Erk-men/stm32-ppg-heart-rate-monitor/Src/systick.c

#include "stm32f0xx.h"
#include "systick.h"

/* D-03: counter is file-local, not exposed via extern */
static volatile uint32_t s_ticks = 0;

void systick_init(void)
{
    /* LOAD = 7999 → (8,000,000 Hz / 1000 Hz) - 1 = 1 ms at HCLK=8MHz */
    SysTick_Config(7999);

    /* Raise SysTick to highest priority per CLAUDE.md §Interrupt Priority Plan */
    NVIC_SetPriority(SysTick_IRQn, 0);
}

uint32_t millis(void)
{
    /* Single 32-bit aligned LDR is atomic on Cortex-M0 — no need to disable interrupts */
    return s_ticks;
}

/* D-02: ISR lives in the driver file that owns the counter */
void SysTick_Handler(void)
{
    s_ticks++;
}
