Erk-men/stm32-ppg-heart-rate-monitor/(commit log)

2026-05-12 feat(01-01): implement SysTick millis() driver (DRV-01)
    - Inc/systick.h: declare systick_init() and millis() public API
    - Src/systick.c: static volatile s_ticks counter (D-03, not extern)
    - SysTick_Config(71999) for 1ms tick at HCLK=72MHz
    - NVIC_SetPriority(SysTick_IRQn, 0) per interrupt priority plan
    - SysTick_Handler lives in systick.c per D-02 (not stm32f1xx_it.c)
2026-05-12 feat(01-01): wire main.c to systick_init() and millis() loop
    - Include systick.h, call systick_init() after SystemInit()
    - 1Hz loop body uses unsigned subtraction (now - last) for rollover safety
    - __NOP() breakpoint anchor; Plan 02 will replace with uart_write call
    - No HAL_ calls
    [main.c]
2026-05-12 feat(phase-01): project scaffold, CMSIS headers, SysTick driver, main stub
    - STM32CubeIDE Empty project for Nucleo-F103RB (Cortex-M3, 72MHz HSE+PLL)
    - Downloaded CMSIS Core + STM32F1xx device headers into Drivers/
    - system_stm32f1xx.c: SystemInit with HSE 8MHz x PLL9 = 72MHz clock tree
    - stm32f1xx_it.c: default handler stubs; SysTick_Handler absent (lives in systick.c)
    - Inc/systick.h + Src/systick.c: DRV-01 — SysTick_Config(71999), NVIC pri 0, millis()
    - Src/main.c: calls systick_init(), 1Hz breakpoint loop on millis()
    - Builds clean: 0 errors, 0 warnings; flashes to board successfully
    Pending: Task 4 hardware verify (millis() debugger check) — resume next session.
2026-05-19 docs(01-01): close out plan with SUMMARY.md — tasks 1-3 complete, hw verify deferred to 01-02
2026-05-19 feat(01-02): implement USART2 polling TX driver (DRV-02)
    - Inc/usart.h: declares usart2_init(), uart_write_str(), uart_write_u32()
    - Src/usart.c: GPIOA clock on APB2, USART2 clock on APB1, BRR=0x139 (115200@36MHz)
    - PA2 CRL nibble=0xB (AF push-pull 50MHz), PA3 CRL nibble=0x4 (floating input)
    - TXE-poll TX loop; uart_write_u32 handles 0 and UINT32_MAX via 10-char stack buf
    - No stdlib formatting, no HAL, no DMA, no interrupts
2026-05-19 feat(01-02): wire main.c to print millis via USART2 every 1000ms
    - Add #include "usart.h"; call usart2_init() after systick_init()
    - Print banner "\r\n--- HeartRateSensor Phase 1 ---\r\n" on reset
    - 1Hz branch: uart_write_str("millis: ") + uart_write_u32(now) + uart_write_str("\r\n")
    - Unsigned subtraction (now - last) rollover-safe per threat model
    - No HAL, no delay loops
    [main.c]
2026-05-19 fix(01-02): add stddef.h for NULL in usart.c
    [usart.c]
2026-05-19 feat(port): migrate project from STM32F103RB to STM32F070RB
    - Add F070xB CMSIS headers (stm32f0xx.h, stm32f070xb.h, core_cm0.h)
    - Rewrite system_stm32f0xx.c: HSE 8MHz x PLL6 = 48MHz clock tree
    - Rewrite usart.c: MODER/AFR GPIO config, ISR/TDR registers, BRR=0x1A1
    - Update systick.c: SysTick_Config(47999) for 1ms at 48MHz HCLK
    - Update all includes: stm32f1xx.h -> stm32f0xx.h
    - Update build: cortex-m0, STM32F070xB defines, F070 startup file
    - Add F070 linker script (same 128KB/16KB memory layout as F103)
2026-05-19 debug(f070): switch to HSI 8MHz diagnostic build (BRR=0x45, SysTick=7999)
    No serial output yet. Suspected causes: wrong USART2 AF number or
    GPIO not reaching PA2. Next: verify AF table from F070 datasheet.
    [usart.c]
2026-05-19 docs(02): research phase ADC+TIM3 hardware trigger for STM32F070xB
2026-05-19 docs(02): create Phase 2 ADC + TIM3 hardware trigger plans
    Two-plan wave structure for Phase 2 (STM32F070RB):
    - 02-01-PLAN: tim3.c/h (PSC=79,ARR=999,TRGO) + adc.c/h (HSI14, ADCAL, TIM3_TRGO EXTSEL=011, ADC1_IRQHandler)
    - 02-02-PLAN: wire drivers into main.c, stream "adc: NNNN\r\n", human-verify range + 100Hz rate
    All register values sourced from 02-RESEARCH.md (F070-specific). No TIM2, no F103 register names.
2026-05-19 feat(02-01): add TIM3 100 Hz TRGO driver
    - PSC=79, ARR=999 -> 100 Hz update event at HSI 8 MHz
    - CR2=TIM_CR2_MMS_1 routes Update Event to TRGO output for ADC1 trigger
    - No TIM3 interrupt enabled; counter runs autonomously
    - No EGR.UG to avoid spurious startup TRGO pulse
    [tim3.c]
2026-05-19 feat(02-01): add ADC1 hardware-triggered ISR driver
    - PA0 analog mode, HSI14 14MHz ADC clock, single-step ADCAL calibration
    - CFGR1: EXTSEL=011 (TIM3_TRGO), EXTEN=01 (rising edge), OVRMOD set
    - SMPR=0x7 (239.5 cycle sample time for max SNR at 100Hz)
    - CHSELR=CHSEL0 (ADC_IN0 = PA0), IER=EOCIE, NVIC priority 1
    - ADC1_IRQHandler stores 12-bit DR into g_adc_sample, sets g_adc_ready=1
    - No F103 register names (RSTCAL/SQR3/SMPR2/CR2/ADC1_2_IRQn)
2026-05-19 docs(02-01): complete ADC + TIM3 hardware trigger drivers plan
    - SUMMARY.md for plan 02-01: tim3.c/h and adc.c/h drivers
    - Records decisions: TIM3 not TIM2, PSC=79, HSI14 clock, EXTSEL=011
    - Self-check: PASSED
2026-05-19 feat(02-02): wire tim3_init + adc_init into main.c with 100 Hz ADC print loop
    - Add tim3.h and adc.h includes to main.c
    - Call tim3_init() after usart2_init() to start 100 Hz TIM3 TRGO
    - Call adc_init() to calibrate and arm ADC1 hardware trigger
    - Replace Phase 1 millis loop with g_adc_ready polling loop
    - Print 'adc: NNNN\r\n' for each 12-bit sample at 100 Hz
    - Update banner to '--- HeartRateSensor Phase 2 ---'
    - Mirror updated main.c from CubeIDE workspace to git repo
    [main.c]
2026-05-19 fix(02): rename ADC1_IRQHandler to ADC_IRQHandler to match F070 vector table
    [adc.c]
2026-05-19 docs(02): add code review — clean (one fix already applied)
2026-05-19 docs(phase-02): complete phase execution — verification passed
2026-05-20 docs(03): create phase plan — 2 plans, 2 waves
    Algorithm Modules on Synthetic Data: moving average (SIG-01) in
    Wave 1, full state machine + refractory + bounds + rolling avg
    (SIG-02–05) in Wave 2. MVP vertical-slice structure.
2026-05-20 feat(03-01): define algorithm module contract and 32-sample moving average
    - Inc/algorithm.h: header guard ALGORITHM_H, stdint.h include, two-function
    contract (algorithm_init / algorithm_process), no extern globals
    - Src/algorithm.c: SIG-01 32-sample integer moving average with circular
    buffer, s_ma_sum >> 5 divide, (s_ma_idx+1) & 0x1F index wrap
    - Minimal Plan 01 peak detector: fixed 1000-count threshold crossing,
    60000UL/interval_ms BPM print via uart_write_str two-call pattern
    - T-03-03 mitigated: interval_ms != 0 guard before divide
    - T-03-04 mitigated: algorithm_init() zeros all static state
    [algorithm.c, algorithm.h]
2026-05-20 feat(03-01): wire SYNTHETIC_TEST sine table and algorithm into main.c
    - Add #define SYNTHETIC_TEST and #define DEBUG_STATE as first two lines
    - Add #include "algorithm.h" after adc.h
    - Add file-local static const uint16_t sine_table[100] under #ifdef
    SYNTHETIC_TEST — 100-entry PPG-shaped waveform (baseline ~200, systolic
    peak 2040 at idx 16, dicrotic notch ~800 at idx 48, flat baseline 65-99)
    - Replace Phase 2 while(1) body with #ifdef/#else guarded branches:
    SYNTHETIC_TEST path advances sine_table every 10ms via millis() delta
    and calls algorithm_process(sine_table[s_table_idx]); live ADC path
    preserved behind #else calling algorithm_process(g_adc_sample)
    - Add algorithm_init()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
    [main.c]
2026-05-20 docs(phase-03): update tracking after wave 1 — plan 03-01 complete
2026-05-20 feat(03-02): implement five-state adaptive-threshold peak detector with refractory and rolling BPM
    - typedef enum { IDLE, RISING, PEAK_HOLD, FALLING, REFRACTORY } peak_state_t with 350ms REFRACTORY_MS constant
    - PEAK_HOLD updates adaptive threshold via s_peak_val * 3 / 5 (integer multiply before divide, SIG-02)
    - REFRACTORY state suppresses dicrotic-notch secondary peak for 350ms after each beat (SIG-03)
    - BPM bounds check rejects values outside 40-200 before s_bpm_buf insertion (SIG-04)
    - 5-entry rolling average ring buffer with s_bpm_count clamped at 5, index via % 5 (SIG-05)
    - DEBUG_STATE gate emits state name literal on transition only, not per sample (D-04)
    - algorithm_init() resets all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
    [algorithm.c]
2026-05-20 docs(03-02): complete algorithm full signal-processing chain plan
    - SIG-02 adaptive threshold, SIG-03 refractory suppression, SIG-04 bounds, SIG-05 rolling average
    - SUMMARY documents all threat mitigations applied and decisions made
2026-05-20 docs(phase-03): update tracking after wave 2 — plan 03-02 complete
2026-05-20 fix(03): CR-01 correct USART2 BRR to 0x1A1 for 115200 baud at 48MHz
    [usart.c]
2026-05-20 fix(03): CR-02/WR-02/WR-06 snapshot millis(), elapsed refractory, RISING hysteresis
    [algorithm.c]
2026-05-20 fix(03): WR-01/WR-05 correct SysTick LOAD to 47999 for 48MHz, fix Cortex-M0 comment
    [systick.c]
2026-05-20 fix(03): WR-03/WR-04 add #ifndef guards for SYNTHETIC_TEST/DEBUG_STATE, fix table_idx increment
    [main.c]
2026-05-20 docs: correct hardware to STM32F070RB — update CMSIS, GPIO, ADC, TIM, USART, SysTick, gotchas
2026-05-20 fix(hw): correct four root causes blocking Phase 3 hardware output
    - STM32F070XBTX_FLASH.ld: RAM LENGTH 20K→16K (F070RB has 16KB SRAM;
    20KB from F103 template put _estack at 0x20005000, HardFaulting every
    function call)
    - Src/adc.c: rename ADC_IRQHandler → ADC1_IRQHandler to match F070
    startup vector table (wrong name silently aliased to Default_Handler)
    - Src/main.c: guard tim3_init/adc_init with #ifndef SYNTHETIC_TEST;
    ADC interrupt firing in synthetic mode trapped CPU before any output
    - Src/systick.c: SysTick_Config 47999→7999 (1ms at actual 8MHz HSI)
    - Src/usart.c: BRR 0x1A1→0x45 (115200 baud at 8MHz PCLK, not 48MHz)
    - Src/system_stm32f0xx.c: document HSI 8MHz as actual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
    [adc.c, main.c, systick.c, usart.c]
2026-05-20 fix(03): DEBUG_STATE define moved to algorithm.c — was invisible to algorithm.c translation unit when defined only in main.c
    [algorithm.c]
2026-05-20 test(03): Phase 3 hardware verification passed — BPM:60 stable, state transitions confirmed, dicrotic notch suppressed
2026-05-20 fix(03): correct usart.c comment — BRR=0x45 is for 8MHz HSI (SystemInit stub), not 48MHz PLL
    [usart.c]
2026-05-20 docs(04): create Phase 4 integration + analog calibration plan
    Two-plan, two-wave breakdown: Plan 1 removes SYNTHETIC_TEST and adds
    CALIBRATION_MODE (OUT-01, OUT-03); Plan 2 adds no-finger detection and
    DEBUG_VERBOSE (OUT-02, OUT-04). Plan 2 depends on Plan 1 because
    FINGER_MIN_AMPLITUDE must be measured empirically on hardware first.
2026-05-20 docs(04): create phase 4 plan — live ADC integration + calibration
2026-05-20 feat(04): live PPG signal working — BPM output confirmed on hardware
    - Invert ADC sample (4095 - sample): red LED reflective PPG is active-high
    (heartbeat increases scattering → ADC rises), not the expected active-low
    - Set fixed threshold 2150: empirically calibrated from hardware measurement
    (inverted DC baseline = 2078, inverted systolic peak = 2279)
    - Comment out DEBUG_STATE for clean BPM-only serial output
    - Calibration data: with-finger amp=315 (min=1816, max=2131), no-finger amp=109
    [algorithm.c, main.c]
2026-05-20 docs: add Turkish technical report (RAPOR.md)
    Complete academic report covering circuit design, firmware architecture,
    signal processing algorithm, calibration results, and hardware test findings.
